Gernreich/practice-chanters/step/practice-chanters-standard-octagon.step

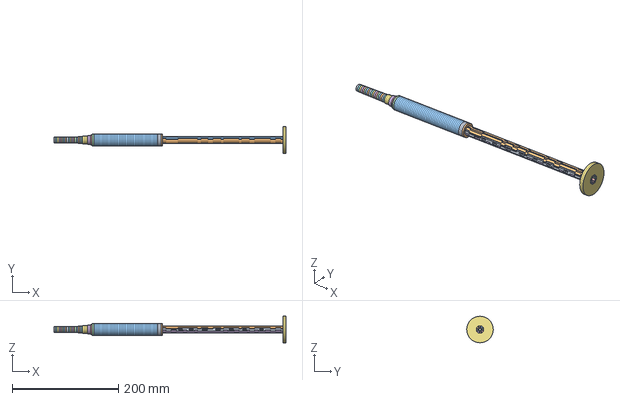
[picture p1: CAD file, 2026-11-08]
step/practice-chanters-standard-octagon.step
436.7 x 50.0 x 50.0 mm
