Gernreich/practice-chanters/step/practice-chanters-stacked-octagon.step

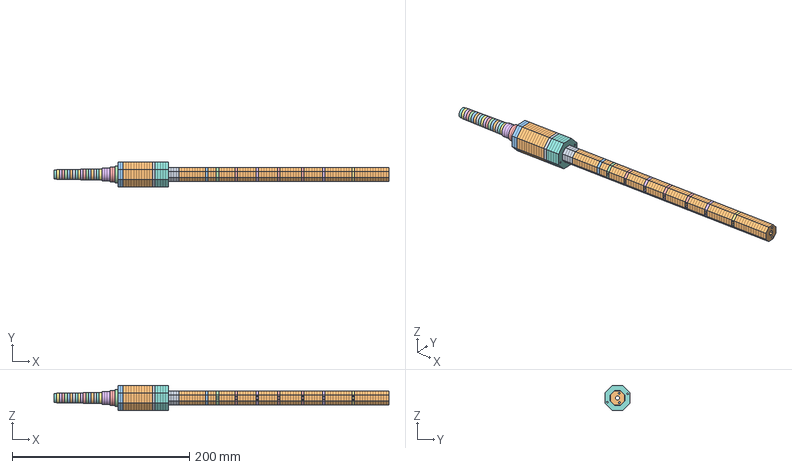
[picture p2: CAD file, 2026-11-08]
step/practice-chanters-stacked-octagon.step
378.0 x 28.6 x 28.6 mm
