Gernreich/practice-chanters/step/practice-chanters-standard.step

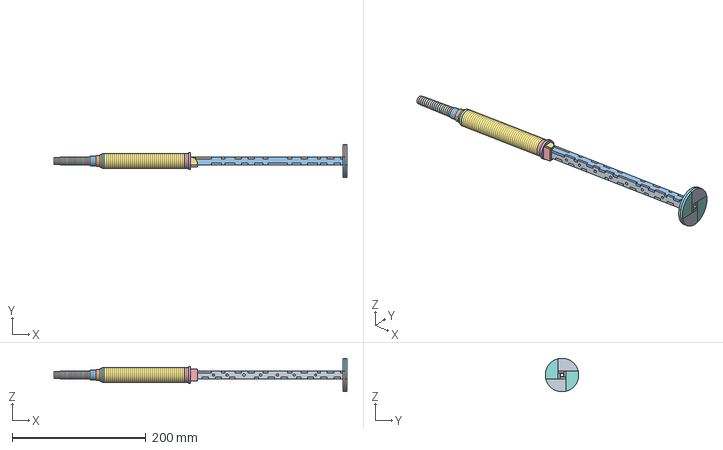
[picture p3: CAD file, 2026-11-08]
step/practice-chanters-standard.step
437.3 x 50.0 x 50.0 mm
