Gernreich/practice-chanters/(commit log)

2026-10-19 Practice chanters: six polygonal bores, stacked plates, cap and mouthpiece
    A Great Highland practice chanter in 3mm ply with a triangular, square,
    pentagonal, hexagonal, heptagonal or octagonal bore of a 4mm bore's area.
    chanter_model.py solves the bore length and every hole's width on the plate
    grid; practice_chanters.py cuts the plates, clamped on two M2 rods, with a
    stacked cap and mouthpiece on press-fit pins, every chanter on one sheet.
2026-10-19 Practice chanters: the square with a round top
    --round-top=F bores the top of the body round from F of the way up (0.8
    by default): 20 bore plates under the seat with a 4mm round hole, the
    square's area, so no note moves. The model takes the round top as design(top=).
2026-10-19 Practice chanters: the strip chanter
    A square bore of four 3mm strips, finger- or butt-jointed and glued, from
    the sole to just above the high A hole; stacked plates above that, round
    bore of the same area, clamped on M2 rods under the cap. The finger holes
    are round and cut in the strips; the model takes a strip wall as
    design(strip=). Replaces the plate chanter with a round top.
2026-10-19 Practice chanters: why the strip chanter's holes are small, corrected
    The wall's thickness was blamed; the model shows it moves the holes less
    than 0.4mm. The hand layout and the bore's face set them.
2026-10-19 Practice chanters: the standard strip chanter
    A measured practice chanter's holes (aero1016's, Thingiverse 6658761),
    where they are under the seat, on a 5.5mm square bore of four strips
    running into the collar, a 10mm band round their top, and a tenon the cap
    slides over. Hole sizes solved for each note to sound where the
    reference's does in the model; the model alone cannot fit the reference,
    which the README now says of the model's own designs.
2026-10-19 Practice chanters: a foot for the standard strip chanter
    Six layers of four 7mm strips lying flat round the strips' bottom, each
    layer turned the other way: 25.5mm square and 18mm tall, the reference
    chanter's foot 25.4mm round and 19mm. Cut the collar's pins flush.
2026-10-19 Practice chanters: round foot, and no band on the back
    The foot's strips are cut to the reference's 25.4mm circle, 6.95mm wide
    mid-face. The band covers the front and sides only, so the thumb has
    22.1mm to the collar, the reference 20.6mm.
2026-10-19 Practice chanters: a jig to glue the foot up in; shellac's effect
    A base and six rings on the foot's circle, pinned into a cup. Four dips
    in shellac flatten the standard strip chanter 1 to 3 cents in the model.
2026-10-19 Practice chanters: round the band's side pieces away from the thumb
    Each side piece loses its lower back corner along a 10mm quarter circle
    up to the collar, so there is no hard edge beside the high A hole.
2026-10-20 Practice chanters: the mouthpiece tapered as a real chanter's
    Every design's mouthpiece now follows the measured practice chanter's top
    piece: a 45 degree shoulder, steps to 16.5 and 14.3mm, then a taper from
    12.4 to 11.0mm to a rounded lip, 72mm long with a 4.5mm blowing hole.
    Each plate is cut to the reference at its mid-height. Too narrow for
    pins, the plates are glued, lined up on a drill shank.
2026-10-20 Practice chanters: the standard strip chanter's cap is the reference's
    A plain round tube, 22.2mm outside and 17.6mm bore, 123mm long, glued with
    no pins, over a round 17mm tenon, resting flush on 22.2mm collar plates;
    the collar's socket plate 25.4mm to cover the band's corners.
2026-10-20 Practice chanters: the standard strip chanter's foot 50mm round
2026-10-20 Practice chanters: the standard octagon
    The standard strip chanter's measured holes on an 8mm octagonal bore of
    eight finger-jointed strips, each hole a slot 2.8mm across and 6.9 to
    10.5mm long. The fingers run as a pinwheel; round each slot its strip owns
    both corners, and the strip opposite narrows to 1.56mm. Two 50mm foot
    plates, and the square's collar, tenon, cap and mouthpiece, now shared
    through standard_chanter.head(). One 599 x 158mm sheet, 87 parts.
2026-10-21 Practice chanters: the standard chanters' review fixes
    Pin the collar and tenon before gluing them to the strips, so the pins can
    be cut flush; seal by dipping, as the shellac paragraph says; the seat
    check says what is true, that the staple is held by its hemp; and the
    README says how much the difference depends on where the reed is modelled.
2026-10-21 --plate=: hand gaps in whole plates, so holes land on plate centres; intro names the hardware
2026-10-21 A hole at its widest moves to the plate above and is narrowed to its note
    High A on the pentagon to the octagon, and on the strip chanter, was held at
    its widest and snapped to the nearest plate, 1.6 to 4.0 cents flat at 3mm and
    past the 5-cent limit at other --plate= values. Now every shape passes at
    2.7, 2.9, 3.2 and 3.5mm. A moved anchor takes its hand with it. Also: the
    reference's hole spacing, B to F 25mm and low A 32mm below B.
2026-10-22 Link back to all projects at the top of the README and the page
    The rest of the build files now points at lasermademusic.html, where the
    instruments moved when the root page became a directory.
2026-10-23 3D view: fitted to its frame, and framed bare at the top of the page
2026-10-23 Keep the stacked octagon alone: drop the triangle to the heptagon
    The five other plate-stack chanters go: their cut files, previews and 3D
    view buttons. practice_chanters.py builds only BUILT = (8,), so --sides
    defaults to 8 and refuses the others; its functions and chanter_model.py
    still take any polygon, which ghb-chanter needs for its 4, 6 and 8 sides.
    The writeup's comparison of the six becomes Why an octagon.
2026-10-24 Stacked octagon: the measured chanter's bore and holes, a 16mm outside
    The bore takes the reference's 4.87mm round bore's area (4.74mm across
    the flats, was 3.89), the outside 16mm across the flats (was 19.5, a
    5.6mm wall where the reference tapers 7.4 to 5.1), and each hole sits in
    the plate the reference's falls in, its slot solved in standard_chanter's
    model to sound the reference's note. Body 264mm (was 396), 131 parts.
    16mm is between the rods' web (15.5 fails) and the widest slot a finger
    closes (17 fails). Seat the reference's, staple held by hemp; chamber
    13mm to stay over the top nuts. strip_chanter keeps its old seat and
    chamber as its own constants, and reproduces unchanged.
    Co-A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
2026-11-07 pack(): ask clear_of() for a yes or no instead of the whole minimum distance
    The packer's 30-step bisection called apart() some 20,000 times a sheet and
    spent 98 of standard_chanter.py's 103 profiled seconds there, in 149 million
    vertex-to-edge distances. clear_of() stops at the first vertex nearer than
    clear and skips edges whose box is already further, with the same distances
    and the same comparison, so every part lands where it did: all 14 files here,
    8 in ghb-chanter and 4 in uilleann-chanter reproduce byte for byte. Their
    reproduction took 86, 22 and 12 seconds; now 17, 6 and 1.4. apart() stays
    for the checks, which report the exact distance.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
2026-11-07 Call lasermade-tools' Rust programs, not its Python scripts
    The tools became Rust on 2026-11-07: target/release/<name> in lasermade-tools
    (cargo build --release there) replaces python3 <name>.py, in commands,
    manifests and prose. Pages rebuilt; no generated file changes otherwise.
2026-11-07 3D page through lasermade-tools' turn3d program; turn3d.py is gone
    The page is byte for byte the same.
2026-11-07 The generators and the chanter model are Rust, every cut file and page byte for byte the same; chanter_bores for bore-tmm
2026-11-08 Cargo.lock: four-hole-ocarinas now builds on square-flute
2026-11-08 Cargo.lock: bore-tmm now depends on lasermade-tools and roxmltree
2026-11-08 STEP files of the 3D view, for a CAD program
    One file per design in step/, one solid body per part, written from the
    3D page by lasermade-tools step-export and checked by .repro. Every file
    opens in SolidCraft with every body closed and no warnings.
    [practice-chanters-stacked-octagon.step, practice-chanters-standard-octagon.step, practice-chanters-standard.step]
2026-11-08 Parametric SolidCraft designs for the three 3D chanters; STEPs built by SolidCraft
    chanters_solidcraft.rs writes the stacked octagon, the standard chanter and
    the standard octagon as SolidCraft scripts (practice_chanters --solidcraft=DIR):
    plates as patterned bodies, the strips' finger joints and hole guards as
    expressions following ply, bore and holes. solidcraft/ holds each script and
    its slim .sc; step/ is now SolidCraft's build of each. Checked part by part
    against the generators' own: 131, 92 and 87 parts within 0.11 mm.
    [practice-chanters-stacked-octagon.step, practice-chanters-standard-octagon.step, practice-chanters-standard.step]
2026-11-11 SolidCraft designs: the standard chanters' tuning follows the ply
    bore_l and each hole's diameter are cubics in the ply, fitted to the
    solver from 2.5 to 3.5 mm (within 0.002 mm), and the cap's plates are
    round(cap_len/ply) as the generator counts them. The stacked chanter's
    solver jumps with the ply and is documented as not following.
